nariox/Hiperion-Copter/README

Este é o repositório GIT do projeto Hiperion.
