nariox/Hiperion-Copter/ESC/Esquema/Bottom.png

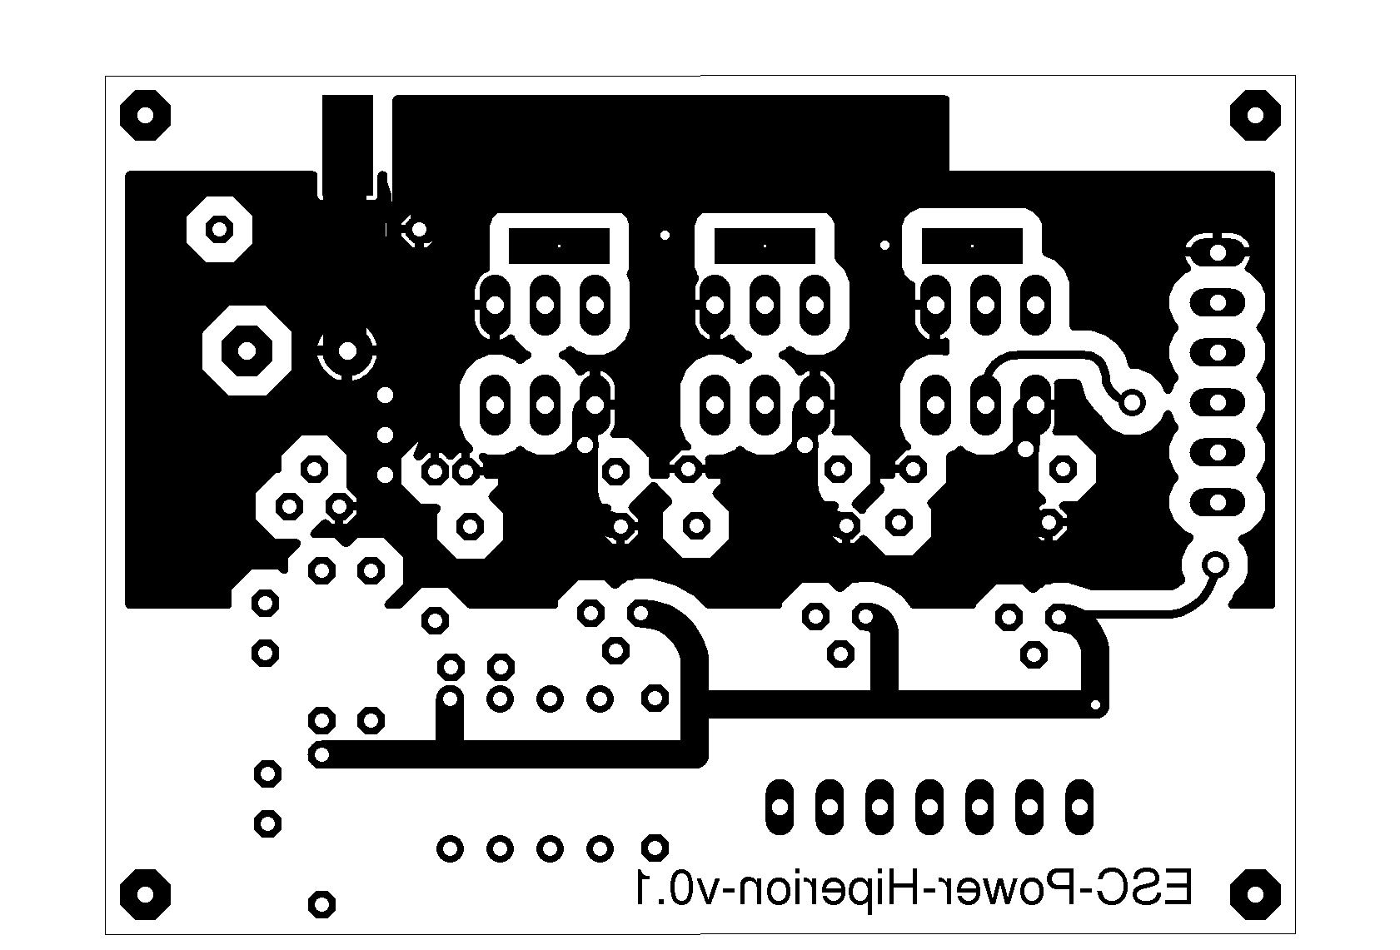
ESC/Esquema/Bottom.png
