nariox/Hiperion-Copter/ESC/Esquema/Top.png

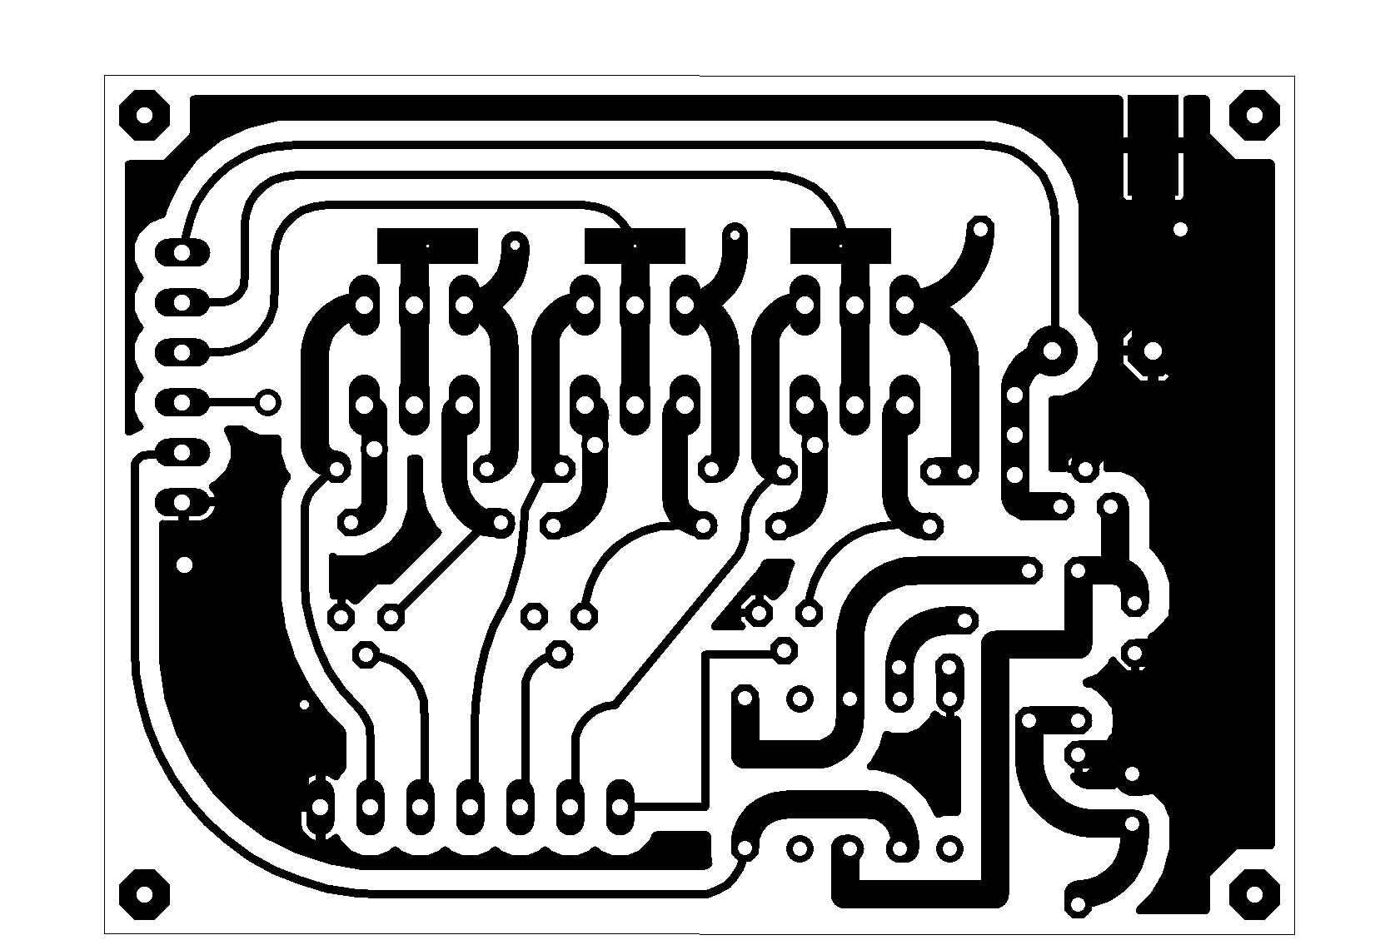
ESC/Esquema/Top.png
