nariox/Hiperion-Copter/Relatorio/Figuras/arquitetura.png

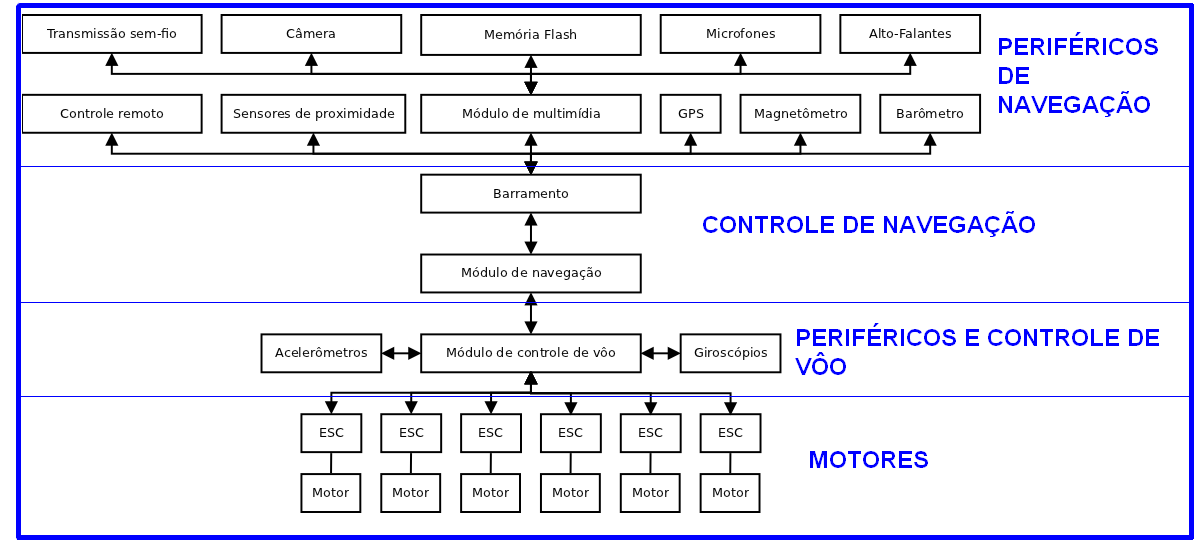
Relatorio/Figuras/arquitetura.png
