nariox/Hiperion-Copter/Relatorio/Figuras/Arquitsimp.png

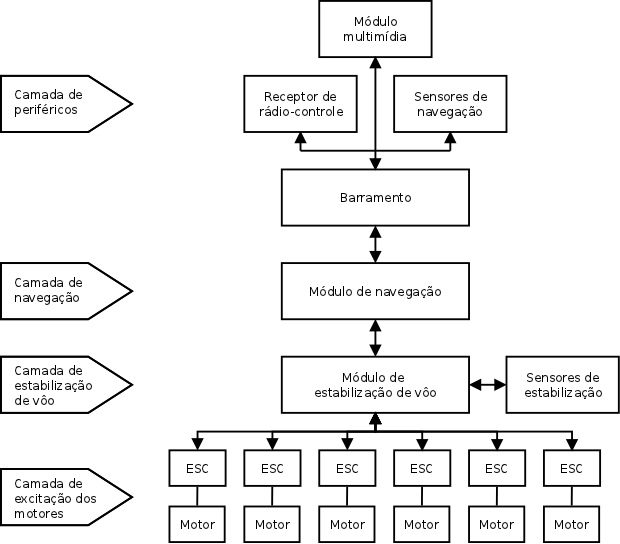
Relatorio/Figuras/Arquitsimp.png
