nariox/Hiperion-Copter/Relatorio/Figuras/correntexhelice.png

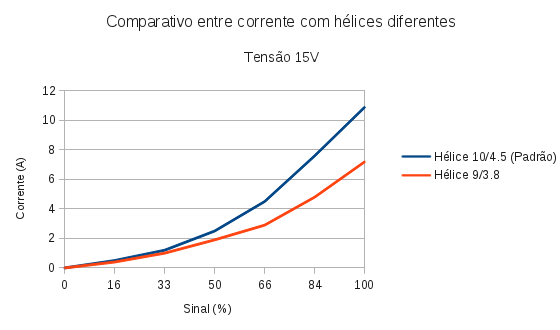
Relatorio/Figuras/correntexhelice.png
