nariox/Hiperion-Copter/Relatorio/Figuras/ESC-chaveamento.png

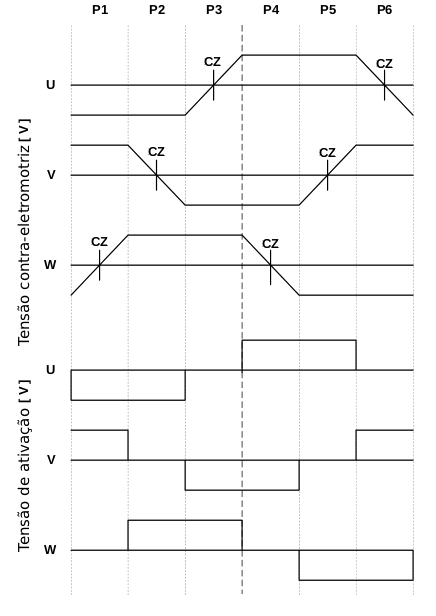
Relatorio/Figuras/ESC-chaveamento.png
