nariox/Hiperion-Copter/Relatorio/Figuras/ESC-comutacao.png

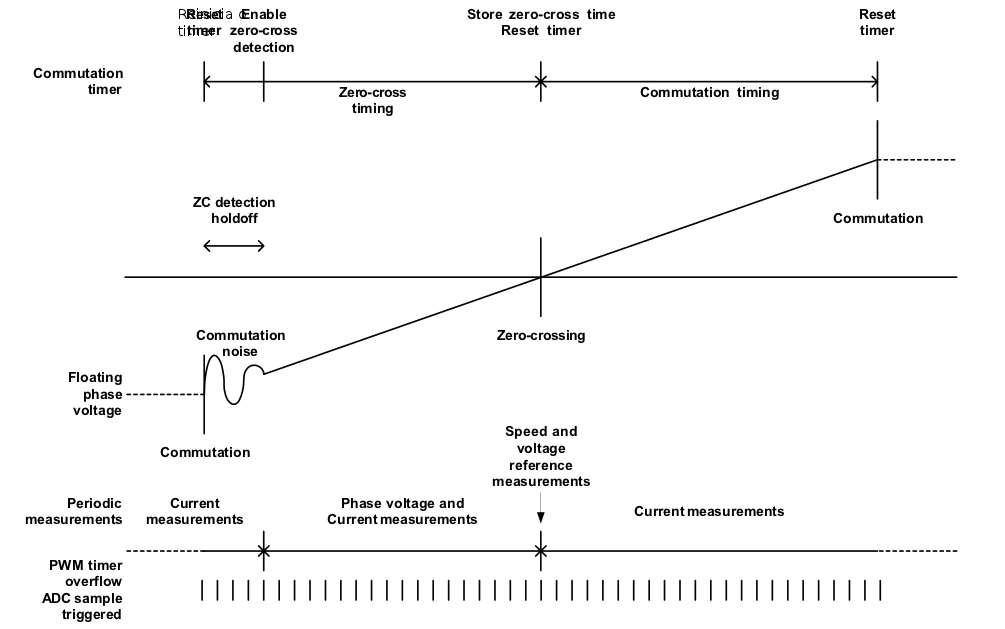
Relatorio/Figuras/ESC-comutacao.png
