nariox/Hiperion-Copter/Relatorio/Figuras/Estab-func.png

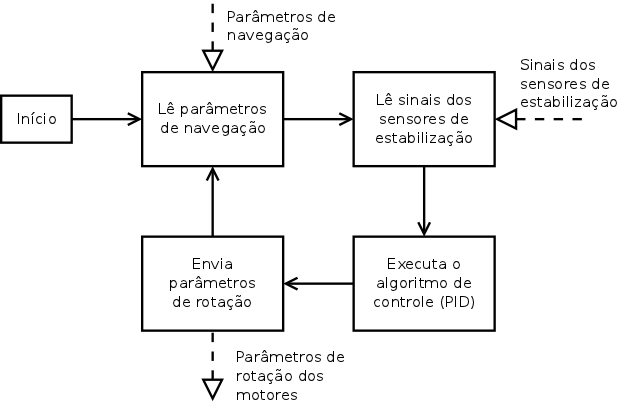
Relatorio/Figuras/Estab-func.png
