nariox/Hiperion-Copter/Relatorio/Figuras/Excit-func.png

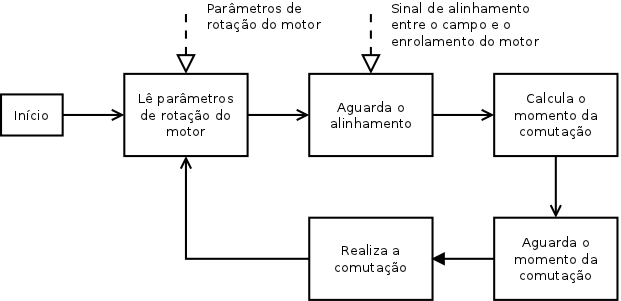
Relatorio/Figuras/Excit-func.png
