nariox/Hiperion-Copter/Relatorio/Figuras/forcaxhelice.png

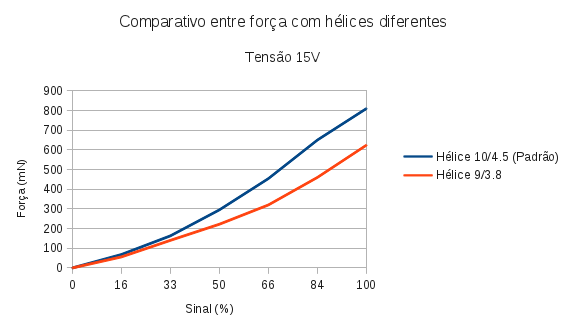
Relatorio/Figuras/forcaxhelice.png
