nariox/Hiperion-Copter/Relatorio/Figuras/modelo.png

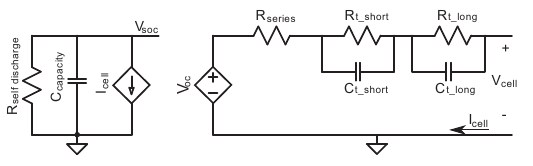
Relatorio/Figuras/modelo.png
