nariox/Hiperion-Copter/Relatorio/Figuras/Navega-func.png

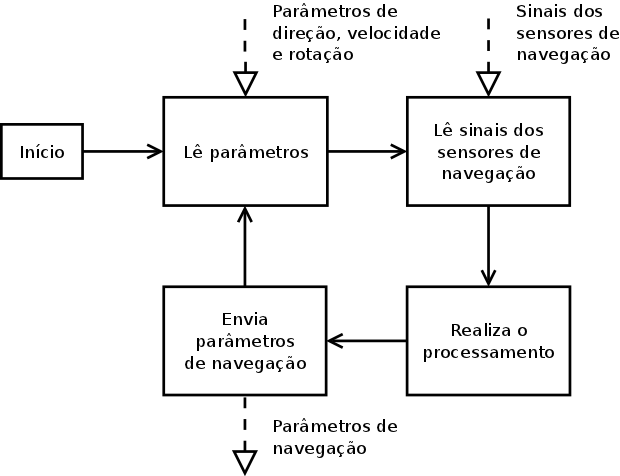
Relatorio/Figuras/Navega-func.png
