nariox/Hiperion-Copter/Relatorio/Figuras/rotacaoxhelice.png

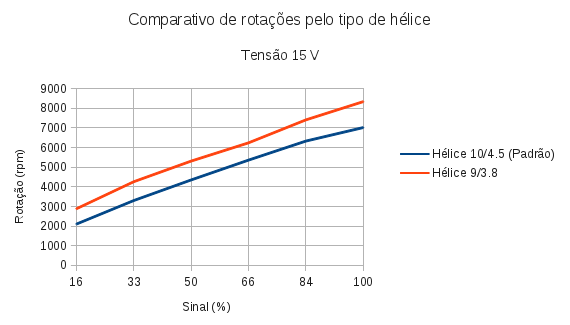
Relatorio/Figuras/rotacaoxhelice.png
