nariox/Hiperion-Copter/Relatorio/Figuras/tensaoxcorrente.png

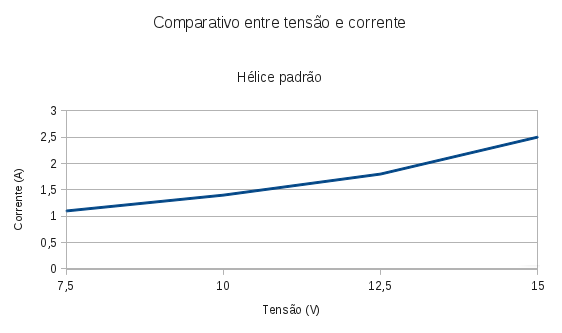
Relatorio/Figuras/tensaoxcorrente.png
