nariox/Hiperion-Copter/Relatorio/Figuras/tensaoxforca.png

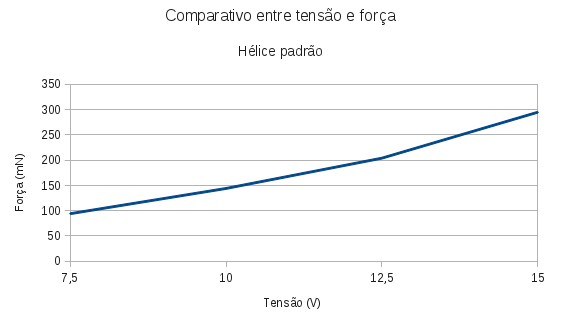
Relatorio/Figuras/tensaoxforca.png
