nariox/Hiperion-Copter/Relatorio/Figuras/tf.gif

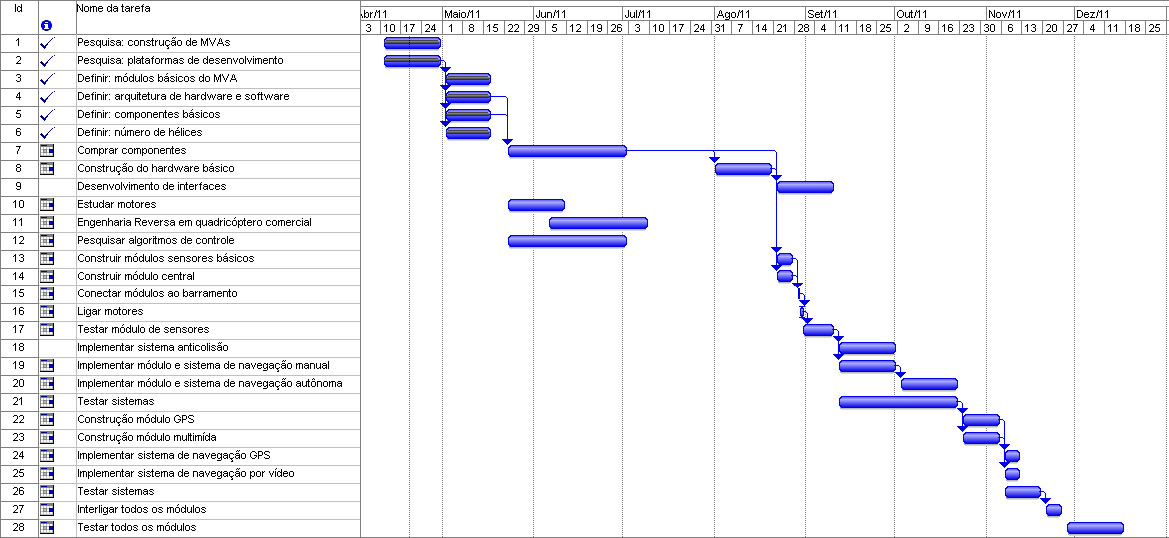
Relatorio/Figuras/tf.gif
