nariox/Hiperion-Copter/ESC/Esquema/ESCTotal.parts.txt

Capacitores
9 x 100n (SMD 0805)
1 x 500uF (Eletrolítico 25V)

Resistores
10 x 4k7 (SMD 0805)
7 x 18k (SMD 0805)
3 x 470 (SMD 0805)
5 x 1k (SMD 0805)
3 x 100 (SMD 0805)

CIs
1x 7805P (TO92)
1x TL071 (DIL08)
1x ATMEGA168 (DIL28)
2x 7408 (DIL14)

Transistores
3x IRFR1205 (SMD DPAK)
3x IRFR5305 (SMD DPAK)
3x BC850 (SMD SOT23)

Conectores
2x DIL 6
2x DIL 7
1x DIL 4

Chaves
1x DIL 3

LED
1x Vermelho (SMD 0805)
