nariox/Hiperion-Copter/ESC/Esquema/Componentes.png

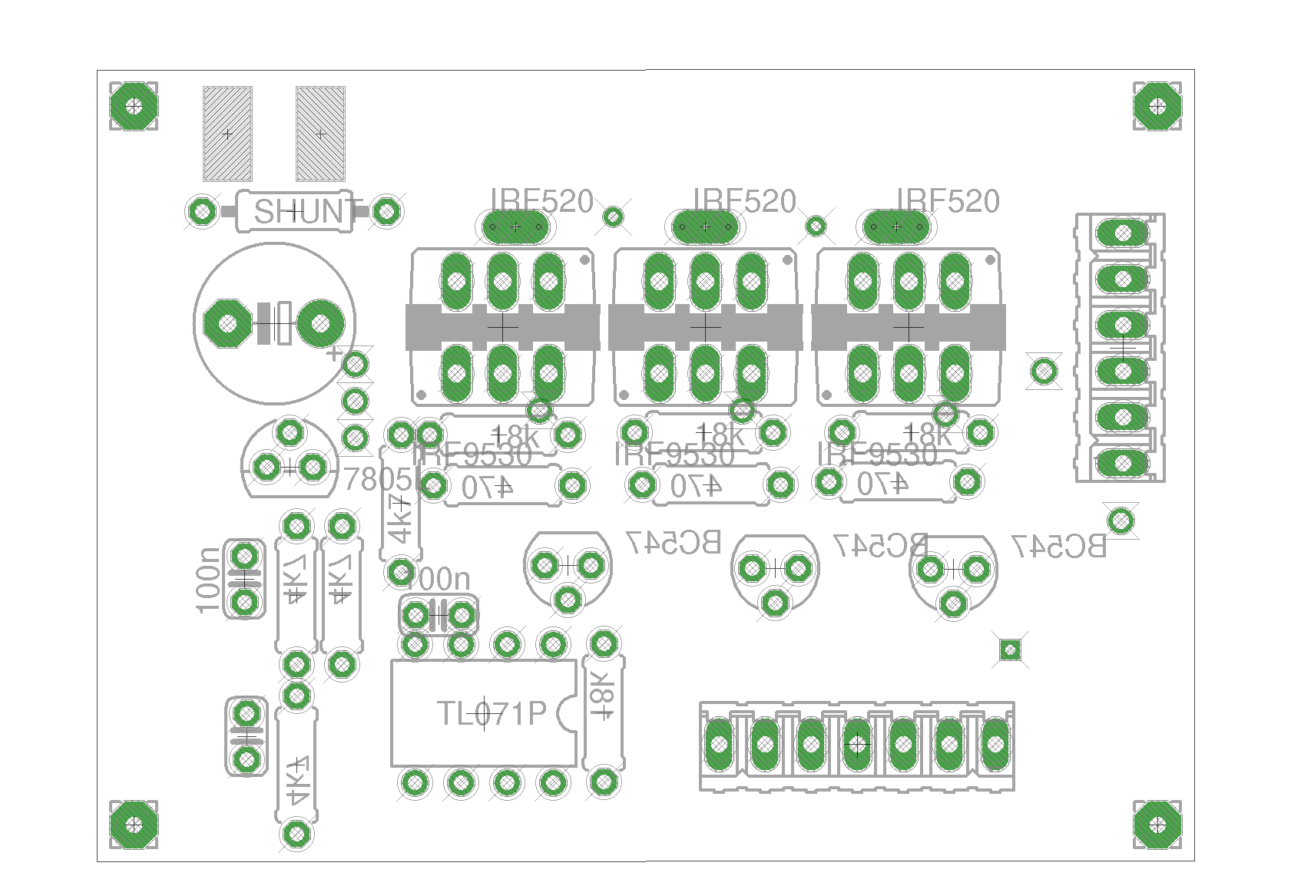
ESC/Esquema/Componentes.png
