nariox/Hiperion-Copter/Relatorio/Figuras/cad_central_inferior.dxf

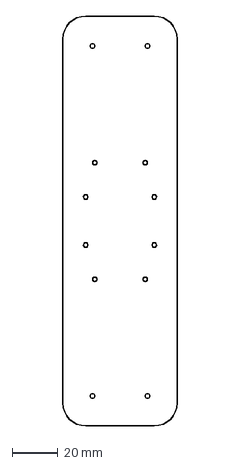
[picture p18: CAD file, 2011-11-30]
Relatorio/Figuras/cad_central_inferior.dxf
50.0 x 179.0 mm
