nariox/Hiperion-Copter/Relatorio/Figuras/cad_central_superior.dxf

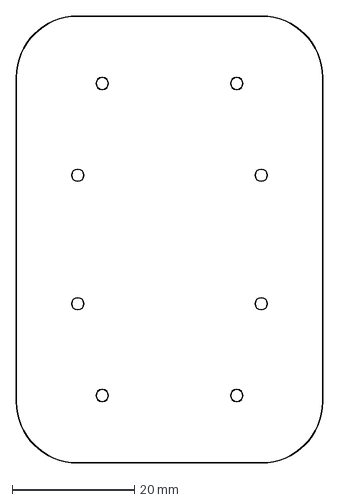
[picture p19: CAD file, 2011-11-30]
Relatorio/Figuras/cad_central_superior.dxf
50.0 x 73.0 mm
