nariox/Hiperion-Copter/Relatorio/Figuras/cad_suporte_motor.dxf

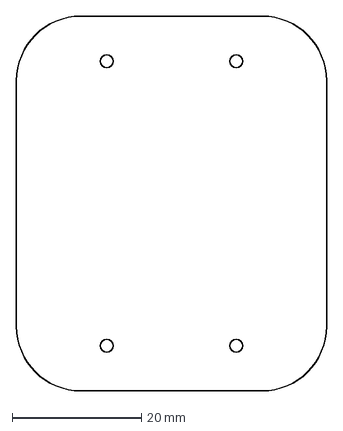
[picture p20: CAD file, 2011-11-30]
Relatorio/Figuras/cad_suporte_motor.dxf
48.0 x 58.0 mm
