nariox/Hiperion-Copter/Controle/todo_controle.txt

TODO:

A IMU tem startup time de 50ms. Fazer o uC esperar 100 ms antes de começar a procesamento.
