nariox/Hiperion-Copter/docs/LPCXpressoLPC1114revA.pdf

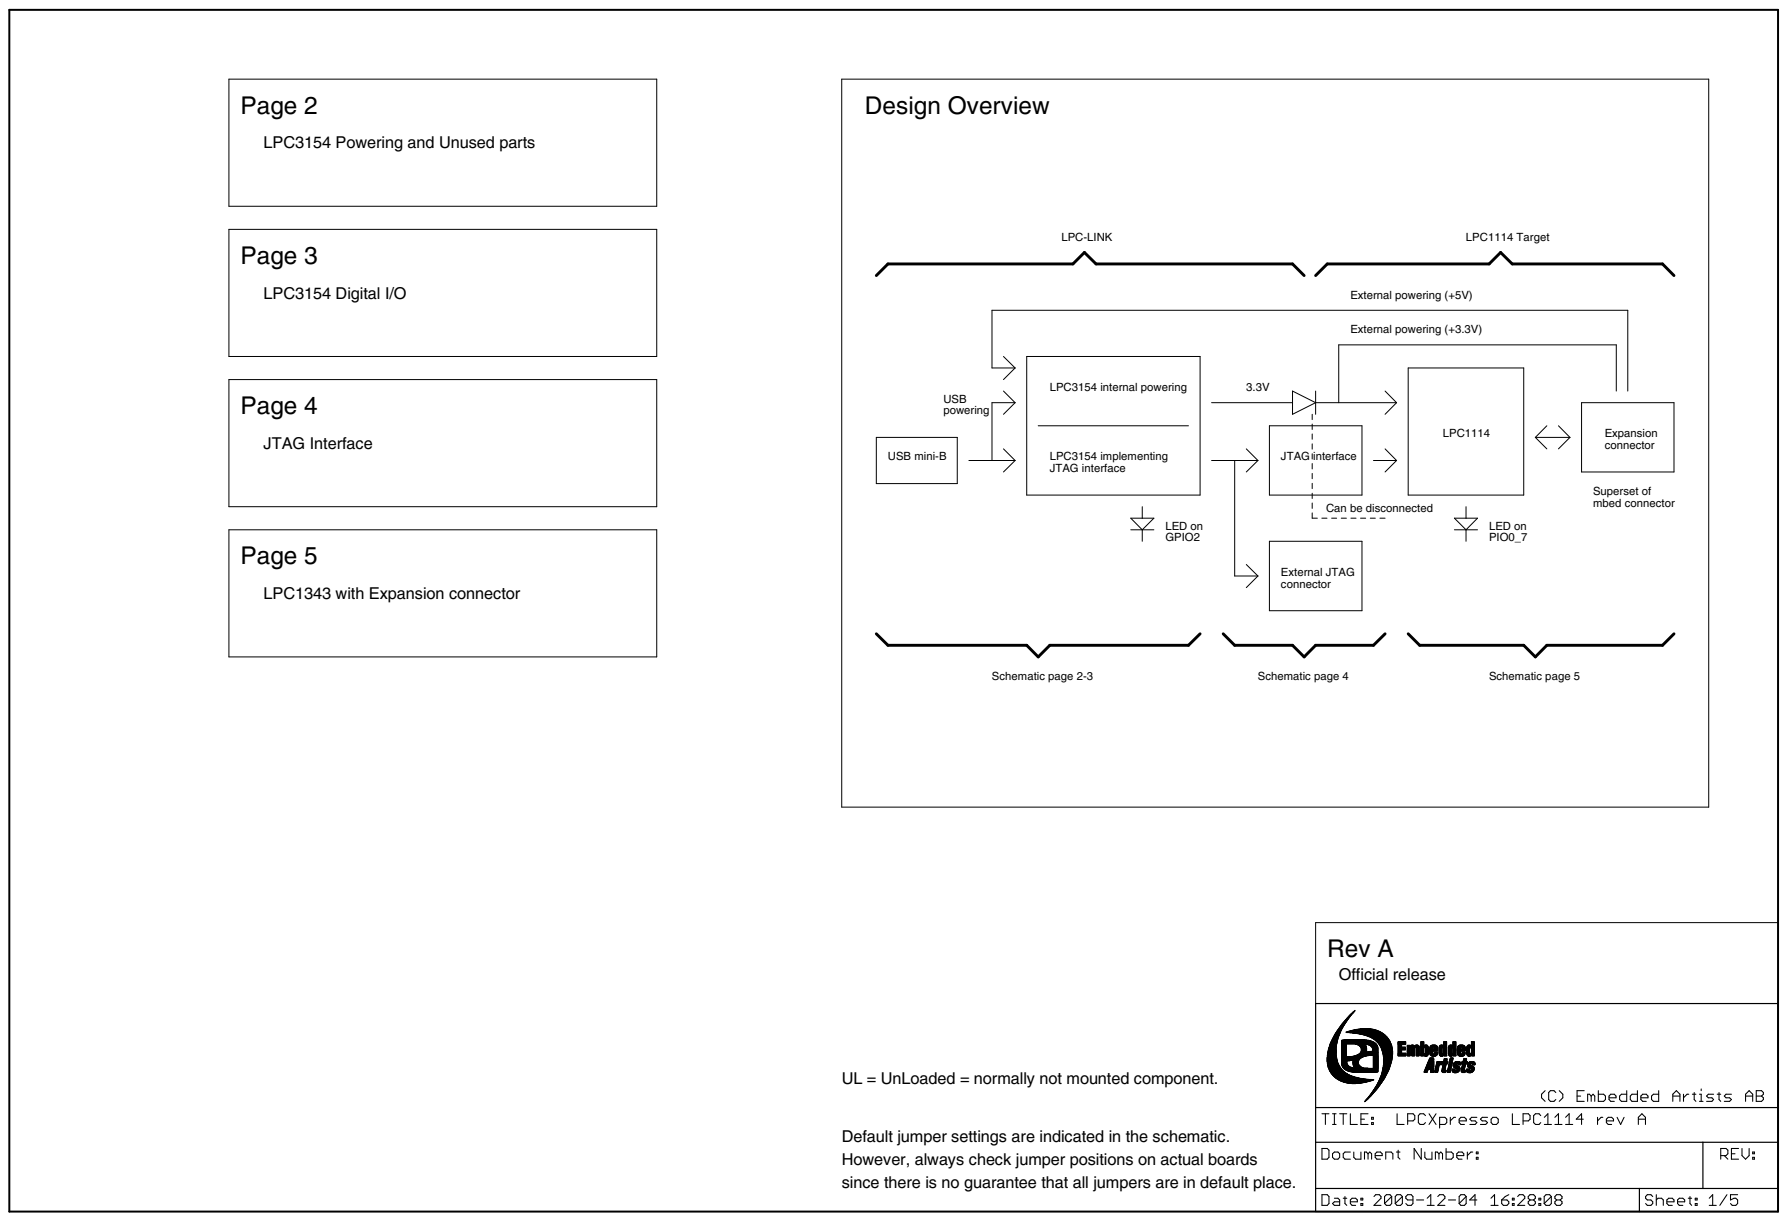
[picture p21: page 1]

LPC3154 Powering and Unused parts

since there is no guarantee that all jumpers are in default place. Default jumper settings are indicated in the schematic. UL = UnLoaded = normally not mounted component.

However, always check jumper positions on actual boards

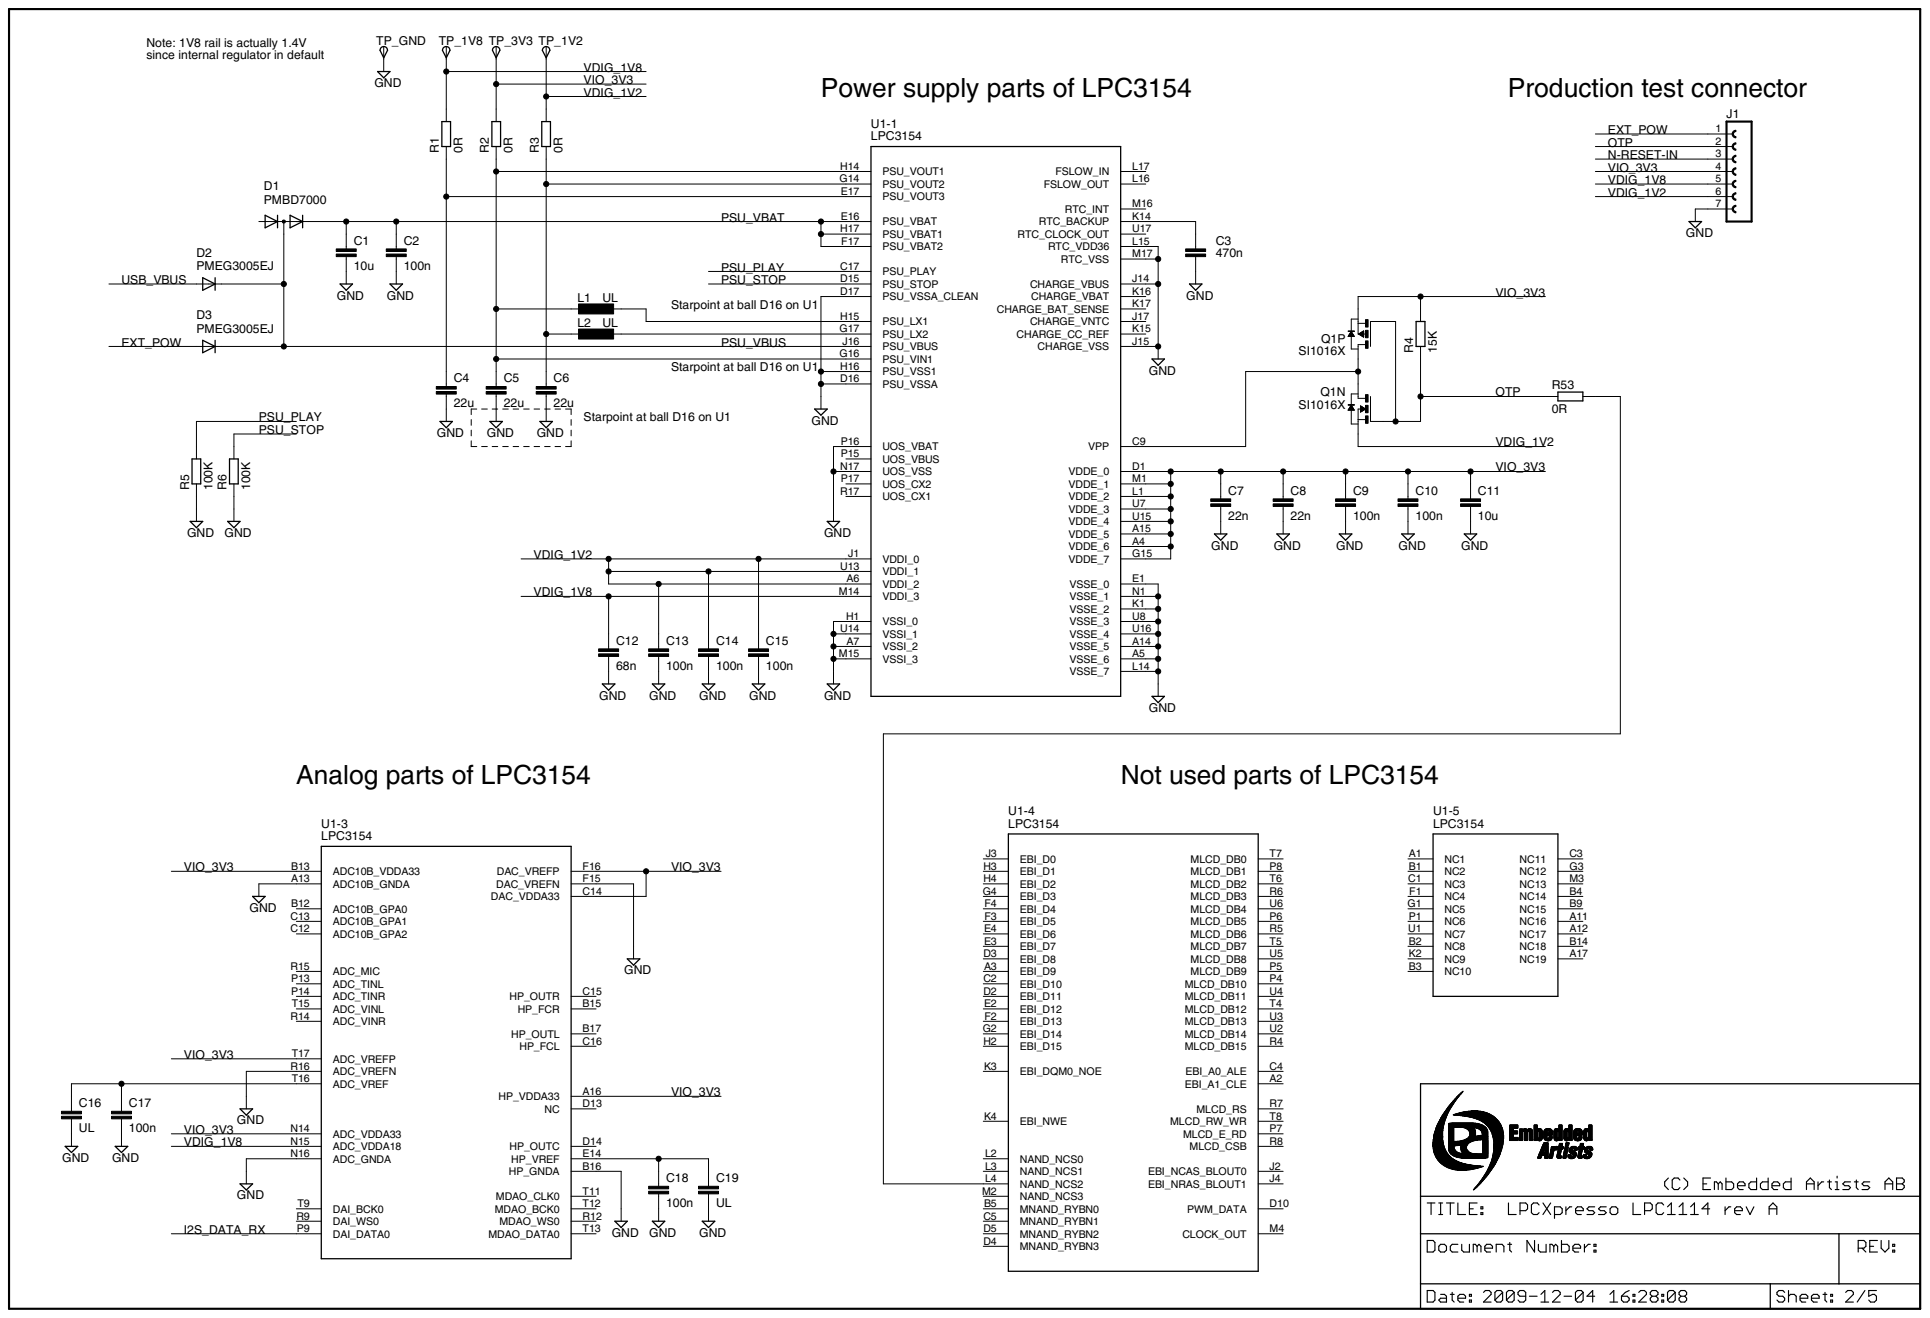
[picture p22: page 2]

Note: 1V8 rail is actually 1.4V
since internal regulator in default

Starpoint at ball D16 on U1

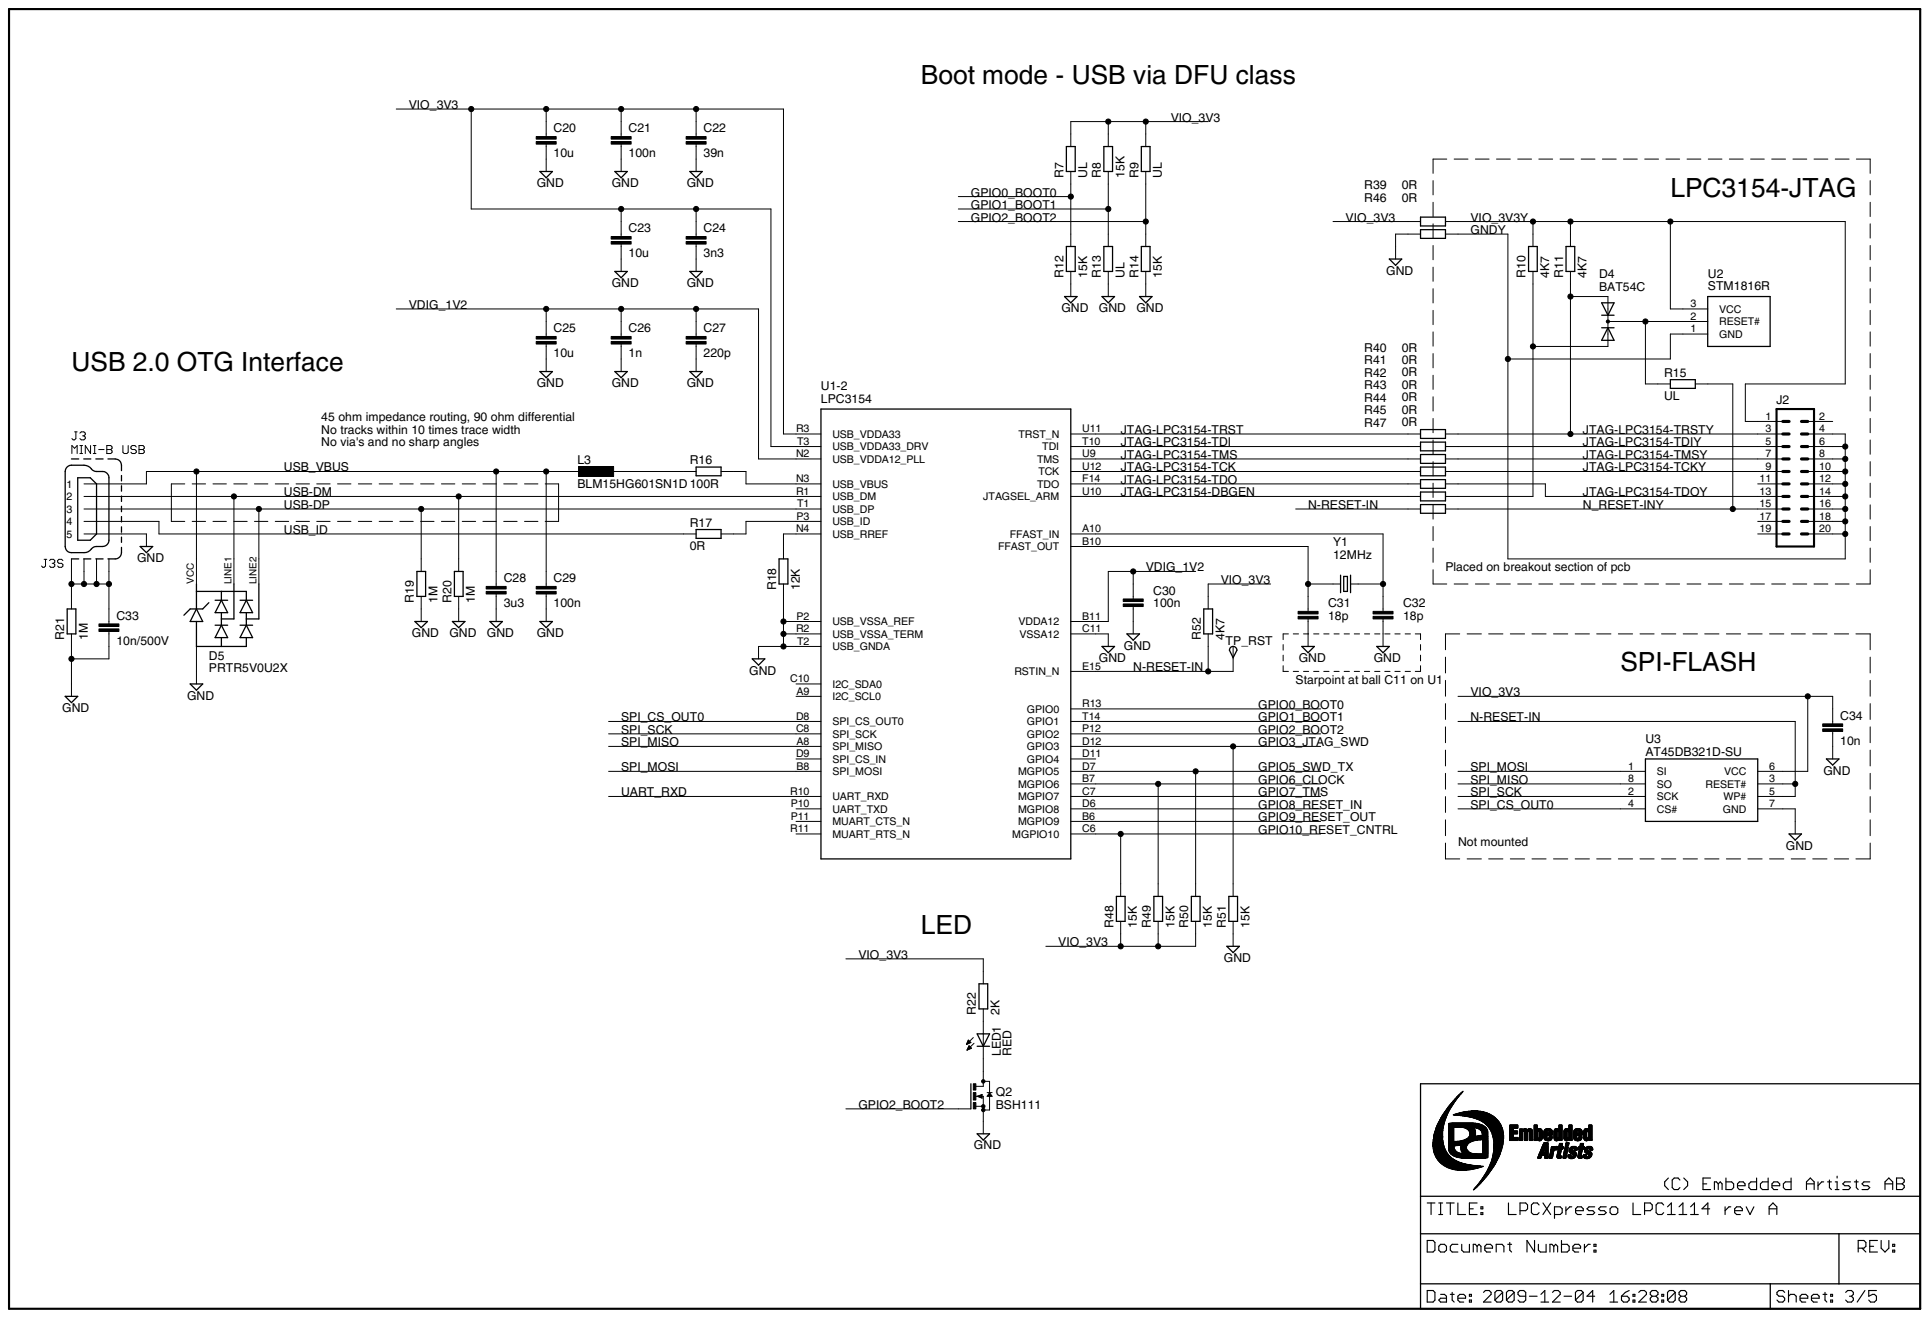
[picture p23: page 3]

Boot mode - USB via DFU class

45 ohm impedance routing, 90 ohm differential No tracks within 10 times trace width No via's and no sharp angles

F14 TCK U12 TMS U9 TDI T10 TRST_N | JTAG-LPC3154-TMSY | 7 | 8

JTAG-LPC3154-TDI JTAG-LPC3154-TMS | JTAG-LPC3154-TDIY | 5 | 6

JTAG-LPC3154-TCK | JTAG-LPC3154-TCKY | 9 | 10

USB-DP | N_RESET-INY | 15 | 16

Placed on breakout section of pcb

Starpoint at ball C11 on U1

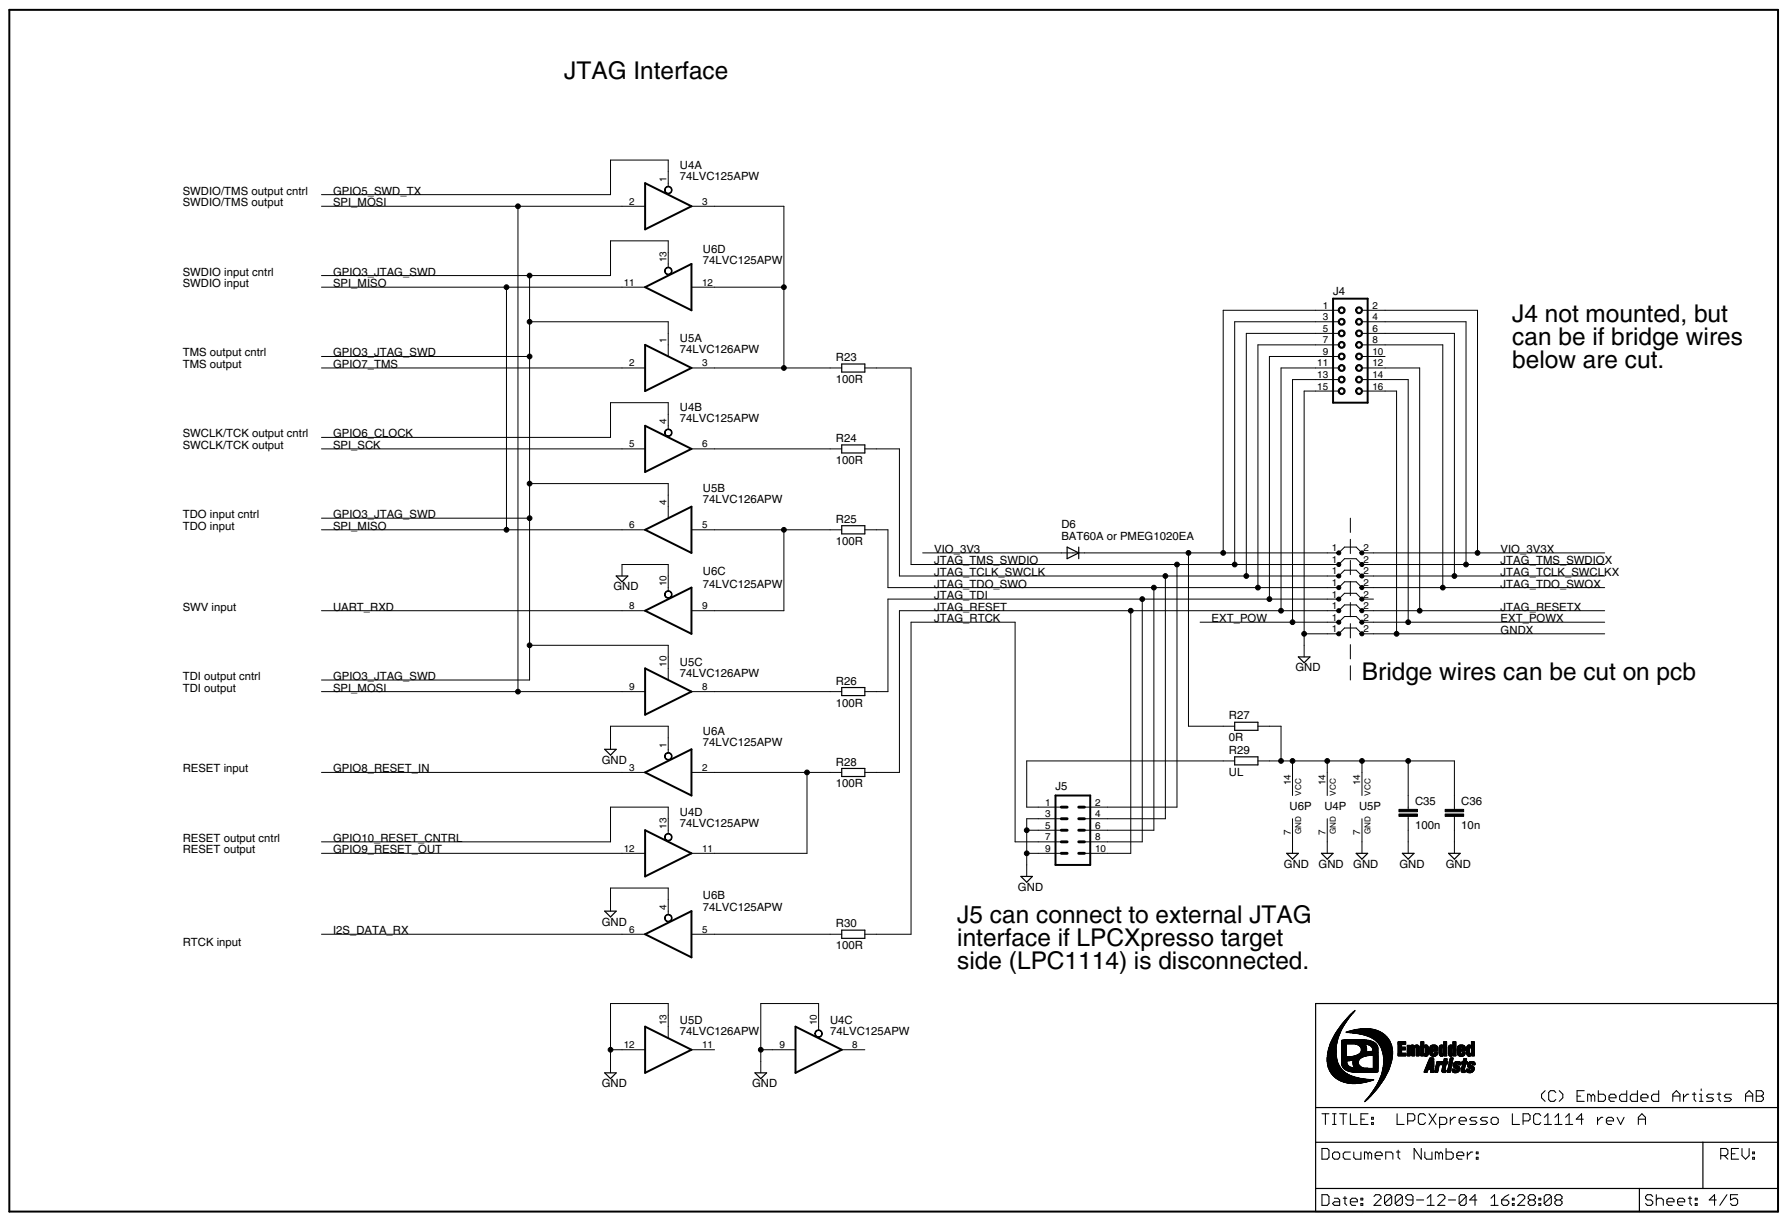
[picture p24: page 4]

SWDIO/TMS output cntrl SWDIO/TMS output SWDIO input

J4 not mounted, but
can be if bridge wires
below are cut.

9 | 10 12

TMS output TMS output cntrl

13 | 14
15 | 16

SWCLK/TCK output cntrl SWCLK/TCK output

TDO input TDO input cntrl

SWV input TDI output cntrl TDI output

JTAG_RESET | 1 | 2
JTAG_RTCK

JTAG_RESETX

Bridge wires can be cut on pcb

RESET output cntrl RESET output RTCK input

J5 can connect to external JTAG
interface if LPCXpresso target
side (LPC1114) is disconnected.

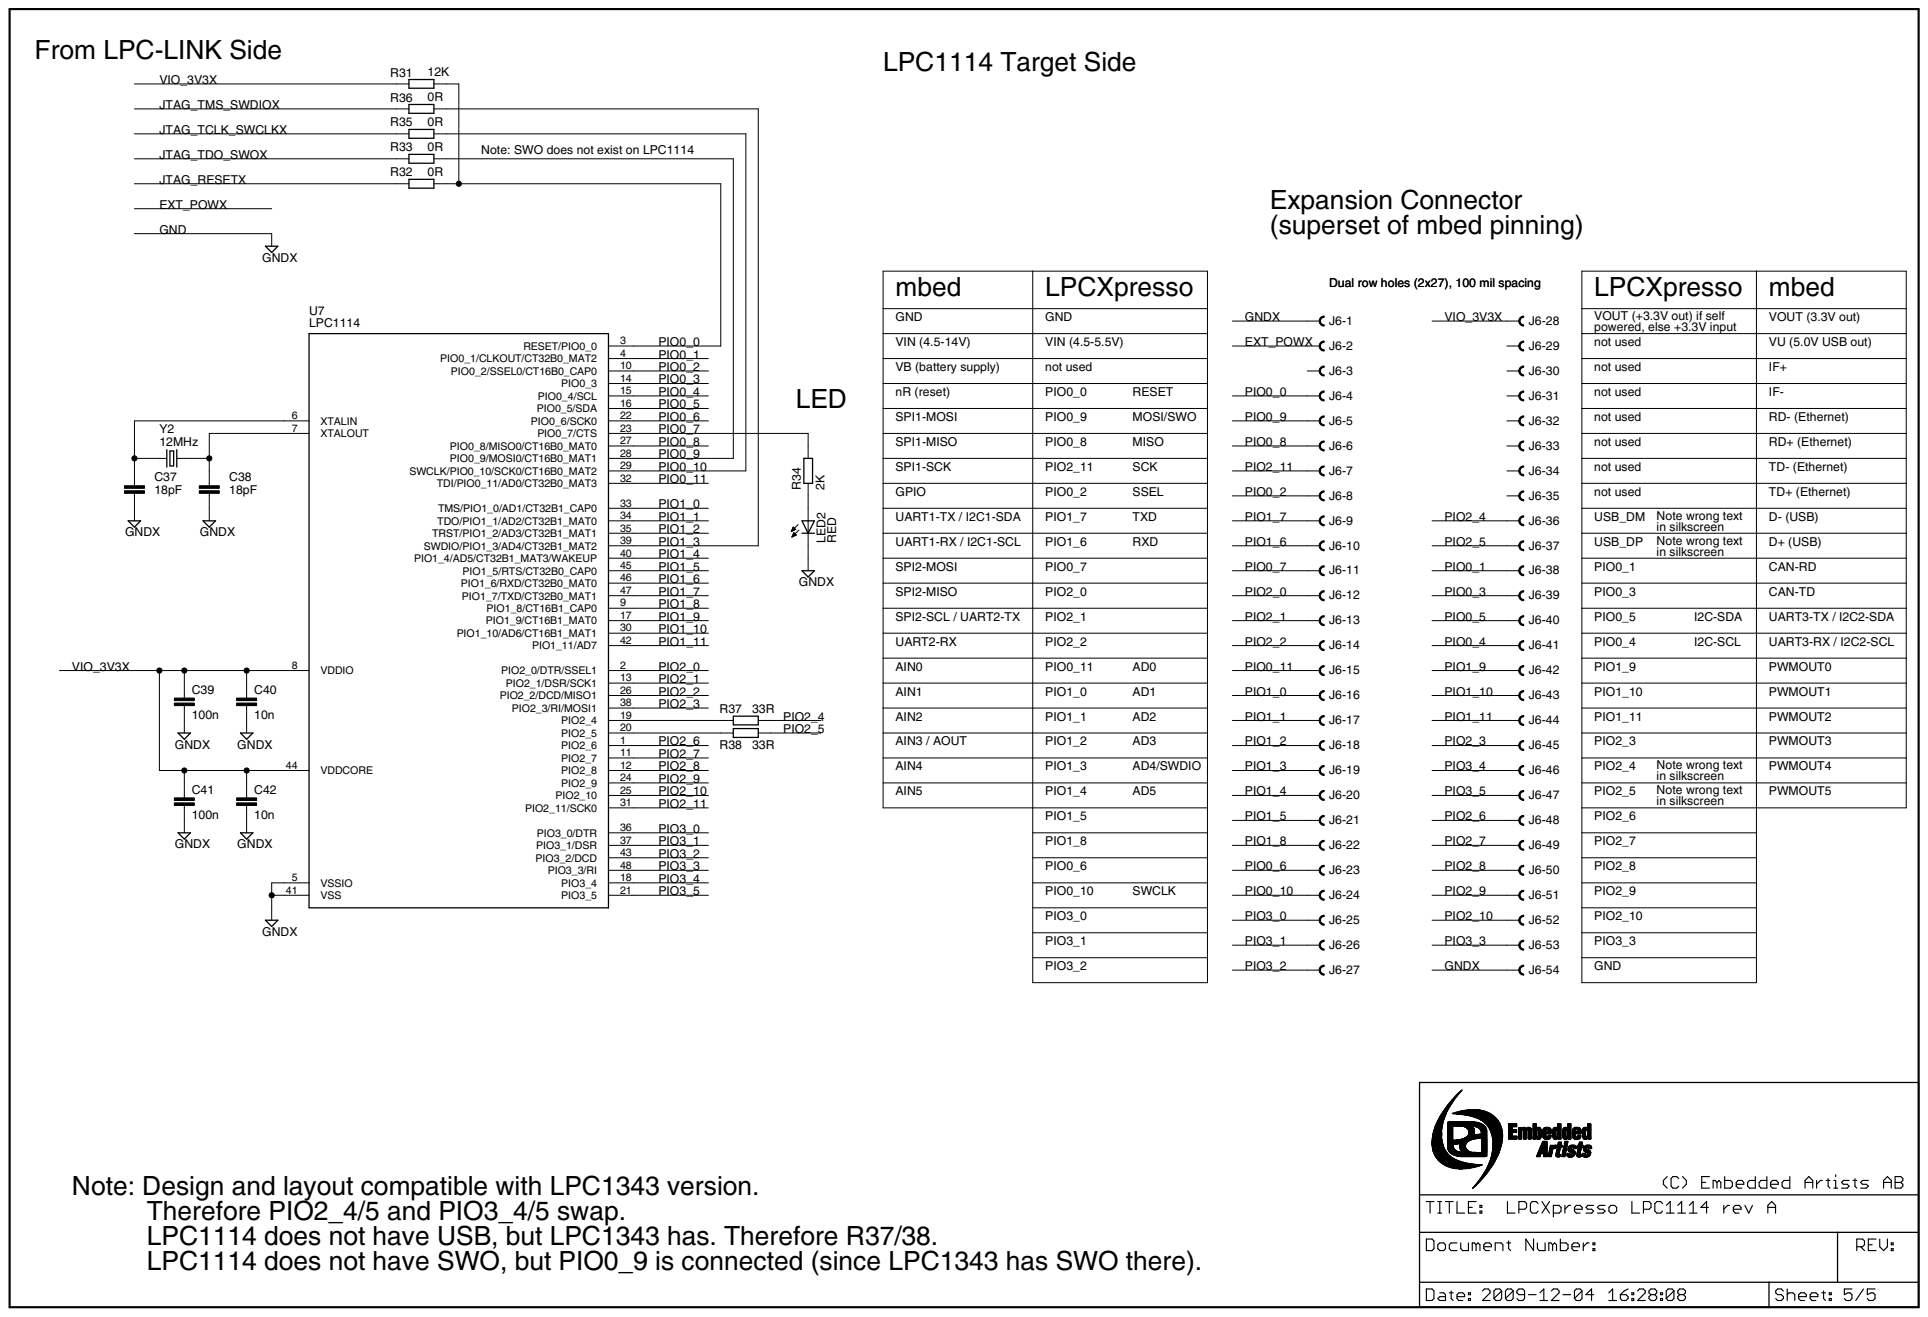
[picture p25: page 5]

From LPC-LINK Side

Note: SWO does not exist on LPC1114

Expansion Connector
(superset of mbed pinning)
VIN (4.5-5.5V) not used PIO0_0 PIO0_9 PIO0_8 PIO2_11 PIO0_2 PIO1_7 PIO1_6 PIO0_7 PIO2_0 PIO2_1 PIO2_2 PIO0_11 PIO1_0 PIO1_1 PIO1_2 PIO1_3 PIO1_4

Dual row holes (2x27), 100 mil spacing

IF- RD- (Ethernet) RD+ (Ethernet) TD- (Ethernet) TD+ (Ethernet) D- (USB) D+ (USB) CAN-RD

VOUT (+3.3V out) if self not used
powered, else +3.3V input

VOUT (3.3V out) VU (5.0V USB out)

VIN (4.5-14V) VB (battery supply) nR (reset) SPI1-MOSI SPI1-MISO

RESET MOSI/SWO MISO

UART1-TX / I2C1-SDA UART1-RX / I2C1-SCL SPI2-MOSI SPI2-MISO

in silkscreen Note wrong text Note wrong text
in silkscreen

UART3-TX / I2C2-SDA UART3-RX / I2C2-SCL PWMOUT0 PWMOUT1 PWMOUT2 PWMOUT3 PWMOUT4 PWMOUT5

in silkscreen Note wrong text Note wrong text in silkscreen

Note: Design and layout compatible with LPC1343 version. Therefore PIO2_4/5 and PIO3_4/5 swap. LPC1114 does not have USB, but LPC1343 has. Therefore R37/38. LPC1114 does not have SWO, but PIO0_9 is connected (since LPC1343 has SWO there).
