nariox/Hiperion-Copter/Controle/src/ADXL345.c

/*
	ADXL345 Library
	
	This libary contains functions to interact with the ADXL345 Triple Axis Digital Accelerometer from Analog Devices written for the ATmega168
	
	created 20 Aug 2009
	by Ryan Owens
	http://www.sparkfun.com
	
 
*/
#include "ADXL345.h"


#define GLOBALOBJECT

//Initialize the I2C communication and put the accelerometer in Measure mode
void Accel_Init()
{

	//Put the accelerometer in MEASURE mode
	I2C_write(ADXL_ADDR, POWER_CTL, MEASURE);
	
	//Set the Range to +/- 4G
	I2C_write(ADXL_ADDR, DATA_FORMAT, RANGE_0);
	
	//default ADXL345 rate is 100 Hz. Perfect!
}

//Read a register value from the ADXL345
//pre: register_addr is the register address to Accel_Read
//	   value is a pointer to an integer
//post: value contains the value of the register that was Accel_Read
//returns: 1-Success
//		   TWSR-Failure (Check out twi.h for TWSR error codes)
//usage: status = accelerometer.I2C_read(ADXL_ADDR, DEVID, &value); //value is created as an 'int' in main.cpp

//Reads the x,y and z registers and stores the contents into x,y and z variables
//returns 1
//usage: accelerometer.update();
//Note: update must be called before using the getX, getY or getZ functions in order
//      to obtain the most recent values from the accelerometer
void Accel_Update(accel_data_t accel_data)
{
	char aux0=0,aux1=0;

	I2C_read(ADXL_ADDR, DATAX0, &aux0);
	I2C_read(ADXL_ADDR, DATAX1, &aux1);
	accel_data->x = (aux1<<8)|aux0;
	accel_data->x_ant = accel_data->x;
	
	I2C_read(ADXL_ADDR, DATAY0, &aux0);
	I2C_read(ADXL_ADDR, DATAY1, &aux1);
	accel_data->y = (aux1<<8)|aux0;
	accel_data->y_ant = accel_data->y;

	I2C_read(ADXL_ADDR, DATAZ0, &aux0);
	I2C_read(ADXL_ADDR, DATAZ1, &aux1);
	accel_data->z = (aux1<<8)|aux0;
	accel_data->z_ant = accel_data->z;
}

/*
get functions return the g value of the specified axis
The conversion is based on a +/-4G range.
If range is changed, make sure to update the scaling in the get functions
usage: printf("Xg = %1.3fg", (double)accelerometer.getX()
*/
/* TODO: remover
void Accel_GetX(void)
{
	Accel_Xr = (float)Accel_X*0.0078;	
}

void Accel_GetY(void)
{
	Accel_Yr = (float)Accel_Y*0.0078;
}

void Accel_GetZ(void)
{
	Accel_Zr = (float)Accel_Z*0.0078;
}
*/
