nariox/Hiperion-Copter/ESC/I2C/I2CAPI.h

/***************************************************************/
/* Comandos TWI - ESC - Projeto Hiperion                       */
/* PLaTooN 2011                                                */
/*                                                             */
/***************************************************************/

// Comandos
#define PARTIDA_MESTRE	 	0x10
#define PARADA_MESTRE		0x11

#define PARTIDA 		0x20
#define PARADA	  		0x21

#define MANDA_PWM		0x22
#define PEDE_RPM		0x23
#define PEDE_CORRENTE		0x24

// Comandos não implementados
/*
MODO DE FREIO
MODO DE ACELERACAO
MANDA_RPM (Modo malha fechada em velocidade)
MUDA_CORRENTE_MAXIMA
MUDA_NUMERO_DE_TENTATIVAS
MUDA_SENTIDO_DE_ROTACAO
*/

 
