nariox/Hiperion-Copter/(commit log)

2011-09-28 Adicionei os arquivos do ESC
    [ESC.brd, ESC.sch, ESClogic.brd, ESClogic.sch, ESCpower.brd, ESCpower.sch, ESCpower3.brd, ESCpower3.sch]
2011-09-28 Revert "Adicionei os arquivos do ESC"
    This reverts commit 228d2282ca7c2314a26c172c39c7551385d483d1.
    [ESC.brd, ESC.sch, ESClogic.brd, ESClogic.sch, ESCpower.brd, ESCpower.sch, ESCpower3.brd, ESCpower3.sch]
2011-09-29 Readicionei os arquivos do ESC
2011-09-29 Atualização do manual - ESC
2011-09-30 Adicionei o Orçamento que o Bruno fez
2011-10-13 Comecei a modificar o código do ESC
2011-10-19 Criado o projeto do controle no LPCXpresso com os arquivos padrões.
    Os arquivos que foram criados pelo LPCXpresso não foram tocados.
2011-10-19 Biblioteca PID portada da biblioteca Arduino, exceto temporização.
    Port inicial da biblioteca PID da comunidade do Arduino (arduino-pid-library, http://code.google.com/p/arduino-pid-library/).
    Esse port já compila mas ainda não é funcional pois a função millis do Arduino (http://www.arduino.cc/en/Reference/Millis) ainda não foi substituída para uma equivalente. Ao compilar, pode-se observar o seguinte warning:
    ../src/PID.c:61:5: warning: implicit declaration of function 'millis'
2011-10-20 Inclusão do manual do lpc1114
    Criação da pasta docs/ e da pasta Navegação/ e inclusão do manual na pasta docs. Criação de um link desse manual na pasta Navegação/ e na pasta Controle/
2011-10-20 Removida a checagem do tempo de amostragem do PID
    O período de amostragem não tem influência no processamento do PID em si. O que ocorre é que, caso tenham sido calculadas as constantes K dos termos proporcional, integral e derivativo, e depois se mude o período de amostragem, as constantes devem ser reajustadas.
    A função millis() do Arduino que estava presente no código apenas garantia que o PID não estava sendo executado antes do período de amostragem, o que é desnessesário aqui já que isso será controlado pela interrupção periódica de um timer. Portanto, essa verificação foi removida, acabando também com o Warning que era gereado pela inexistência da função millis()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
2011-10-25 Incorporado código para ligar com I2C Mestre
    O código do exemplo "i2c" do pacote do LPCXpresso foi incorporado ao projeto, compila e provavelmente funciona sem problemas.
    [I2C.c, I2C.h, main.c]
2011-10-25 Começo da flexibilização dos dados no PID
    O objetivo é poder usar diferentes conjunto de dados (structs) no PID em vez poder usar apenas 1 conjunto, como ocorre atualmente. A modificação ainda não está completa e o programa não compila no estágio atual.
2011-10-25 Adicionei os comandos e o programa do ESC
2011-10-25 Finalização da flexibilização dos dados no PID.
    Agora diversos conjuntos de dados podem ser usados no PID, que passa a requerer um ponteiro para uma struct pid_data_t como argumento em todas as funções.
2011-10-25 O código I2C deixou de funcionar
2011-10-25 O código I2C voltou a compilar.
    Corrigi o bug e o código voltou a compilar
    [main.c]
2011-10-25 Renomeados os arquivos do driver do I2C.
    Os arquivos driver/i2c.* foram renomeados para evitar confusão com os src/I2C.*
2011-10-25 Uso mais eficiente da memória no PID.
    Uso mais eficiente da memória mudando alguns tipos de dados de int para uint8_t ou uint16_t.
2011-10-25 Um pouco de desenvolvimento no main do Controle.
2011-10-26 Implementada a execução periódica do laço principal
    Agora o loop principal é executado a cada Tamostragem ms, quando ocorre a interrupção do timer 0 de 16 bits.
2011-10-26 Mexi mais no codigo do ESC e adicionei a biblioteca do controle (para eagle)
    [ESC.brd, ESC.sch, ESClogic2.brd, ESClogic2.sch, ESCpower.brd, ESCpower3.brd, ESCpower3.sch]
2011-10-27 ESC teste
    [ESClogic2.brd, ESClogic2.sch]
2011-10-27 Início da implementação do SPI (SSP)
2011-10-28 Ei, olha a placa de controle :) (ponto de exclamacao)
    [Esquema.brd, Esquema.sch]
2011-10-31 Subindo o manual da placa LPCXpresso que usamos
2011-11-04 A busca pelo I2C no ESC continua...
2011-11-15 Adicionei a biblioteca do Gyro
2011-11-15 Biblioteca IMU pronta para testes
2011-11-15 Biblioteca IMU+I2C otimizadas
2011-11-15 Biblioteca IMU+I2C otimizadas (2)
2011-11-15 IMU pronto para testar e debugar
2011-11-16 Removidos os arquivos debug.*
    Removidos os arquivos debug.c e debug.h e as referências a eles. Isso foi possível porque é possível verificar o valor de qualquer variável a qualquer momento pelo próprio lpcxpresso, sem a necessidade de imprimir informações na tela.
2011-11-16 Renomeados os arquivos .cpp para .c e correções
2011-11-16 Leitura dos dados da IMU teoricamente funcional.
2011-11-17 Agora o I2C vai pra frente
2011-11-17 A leitura dos sensores da IMU funciona (testado).
2011-11-20 Um pouco sobre sensores
2011-11-27 Um pouco mais sobre sensores
2011-11-27 Título de exemplo de um commit
    Descrição de exemplo do commit. Pode ter várias linhas, diferentemente do título.
2011-11-27 Incluído o módulo 'placeins' na monografia.
    O módulo 'placeins' faz com que as figuras fiquem em suas respectivas seções.
2011-11-27 Sensores 1
2011-11-27 Algumas correções na navegação.
    E remoção de mais alguns arquivos temporários do git.
2011-11-27 Um pouco mais de controle por favor.
2011-11-28 Renomeado o arquivo da mono para mono.tex.
    Além disso, removidos mais alguns arquivos temporários.
2011-11-28 Pequenas correcoes com porcentagem, curvas de relacao
2011-11-28 Mudanças na camada de navegação da arquitetura.
2011-11-28 Finalização das camadas de navegação e periféricos.
    A arquitetura está finalizada. Agora apenas a revisão está pendente nesse capítulo.
2011-11-28 Nossa, que son...ZzZzZzZzZzZ
2011-11-28 Início do manual de reprodução do multirrotor.
    Estrutura básica do manual de reprodução do multirrotor e gabarito das placas centrais e de suporte do motor.
    [cad_central_inferior.dxf, cad_central_superior.dxf, cad_suporte_motor.dxf]
2011-11-30 Gambiarra para formatação
2011-11-30 Lavarrrrroupa todo dia... que agonia... (Mais controle)
2011-11-30 Controle descontrole (Fim de boa parte do controle)
2011-11-30 Incluídas as dimensões nos gabaritos das placas.
    [cad_central_inferior.dxf, cad_central_superior.dxf, cad_suporte_motor.dxf]
2011-11-30 Figuras do controle revertidas para EPS.
    As figuras do controle foram revertidas do formato PNG para EPS pois o formato DVI não suporta PNG, impossibilitando o recurso ForwardDVI.
2011-11-30 Esqueci de commitar as imagens
2011-11-30 Removido o driver SPI e PWMs funcionando.
2011-11-30 Alguns ajustes no PID.
2011-12-01 Modifiquei as imagens para eps
2011-12-03 Trocando a extensão do arquivo arduino para .ino
    Pois a versão 1.0 da IDE lançada recentemente usa essa extensão.
2011-12-03 Mudado diretório da navegação.
    O diretório da navegação foi modificado para o IDE conseguir compilar.
2011-12-03 A biblioteca PID não é mais referenciada no código.
    A biblioteca PID não é mais usada e por isso não é mais referenciada no código. Os arquivos não foram excluídos porque não existem em outros lugares e podem ser úteis em outros projetos.
2011-12-03 Implementada a comunicação UART no controle.
2011-12-03 Rearranjo de código: distância pelo sensor US;
    O código referente ao cálculo da distância pelo sensor ultrassônico ganhou sua própria função.
2011-12-03 Otimizado o envio de dados pelo Arduino
2011-12-03 Conflitos resolvidos - agora de verdade
2011-12-05 Função para o envio dos parâmetros de navegação.
2011-12-05 Implementado o controle integral de altitude.
2011-12-05 Biblioteca ultrasonic atualizada
2011-12-05 Correção: erro de digitação impedia compilação.
2011-12-07 Parte do manual alterada, adiçao de alguns codigos e outros updates
2011-12-07 Adição timer32 no git. Corrigida ortogonalização.
    A ortogonalização estava com um sinal errado, agora está correta.
    [main.c, timer32.c, timer32.h, uart.c, uart.h]
2011-12-07 Implementada filtragem do acelerômetro.
    Filtragem simples, apenas para diminuir o ruído
2011-12-07 Verdadeira navegacao v 1.0. Verificar a existencia de bugs e ajustes finos
    [navegacao.ino]
2011-12-08 Correções pontuais na navegação.
    A inicialização do serial3 estava errada, reativação da sinalização de erro para debug e desligamento dos motores em caso de erro.
2011-12-08 Revert "Correções pontuais na navegação."
    This reverts commit 762f3f4c513d88bdb9417956939f980e0ba10a56.
    [navegacao.ino]
2011-12-08 Alteracao na navegacao, envio de dados bluetooth
2011-12-08 Atualizacao no envio de dados e na taxa de amostragem
2011-12-09 Monografia atualizada, parte dos sensores feitas.
2011-12-09 Correcao no que ja fizemos no relatorio, cap 4
2011-12-09 Melhorando IMU
2011-12-09 IMU - Balanco
2011-12-09 navegacao enviando o throttle para o bluetooth
2011-12-09 Ajustados as constantes do PID.
2011-12-10 Navegacao mandando o throttle corretamente
2011-12-14 Retirados os carriage-return do arquivo da mono.
    De alguma forma eles apareceram lá no commit ad097b6505635ca58ba90e39deb2412e9c61ea1f, feito por Bruno. Talvez o problema de os arquivos que ele alterava serem sobrescritos possa estar relacionado a isso.
